vanceb/rLab_Door/README.md

# rLab_Door
A microcontroller project to allow members access to rLab
