vanceb/rLab_Door/Controller/kicad/README.md

# Production

## Kikit

Instructions for [kikit JLCPCB](https://github.com/yaqwsx/KiKit/blob/master/doc/fabrication/jlcpcb.md)

~~~sh
kikit fab jlcpcb --assembly --schematic rLab_Door.kicad_sch rLab_Door.kicad_pcb kikit_fab
~~~
