vanceb/rLab_Door/Pi_Connector/kicad/kikit_fab/bom.csv

Comment | Designator | Footprint | LCSC
PI | J1 | Connector_IDC:IDC-Header_2x04_P2.54mm_Vertical
Conn_02x20_Odd_Even | J2 | Connector_PinHeader_2.54mm:PinHeader_2x20_P2.54mm_Vertical
NFC SERIAL | J3 | TerminalBlock_Phoenix:TerminalBlock_Phoenix_MPT-0,5-4-2.54_1x04_P2.54mm_Horizontal
2N7002 | Q1,Q2 | Package_TO_SOT_SMD:SOT-23_Handsoldering | C8545
10k | R1,R2,R3,R4 | Resistor_SMD:R_0603_1608Metric_Pad0.98x0.95mm_HandSolder | C25804
SW_DPDT_x2 | SW1 | Button_Switch_THT:SW_CuK_JS202011CQN_DPDT_Straight
