vanceb/rLab_Door/Controller/kicad/3d/TS-1187A v2.iges

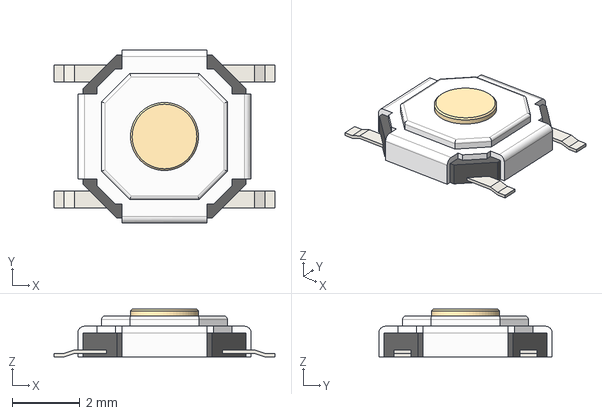
[picture p1: CAD file, 2022-09-25]
Controller/kicad/3d/TS-1187A v2.iges
6.50 x 5.10 x 1.40 mm
