vanceb/rLab_Door/Controller/kicad/rLab_Door.kicad_pcb

## KiCad design Controller/kicad/rLab_Door.kicad_pcb (2022-09-25)

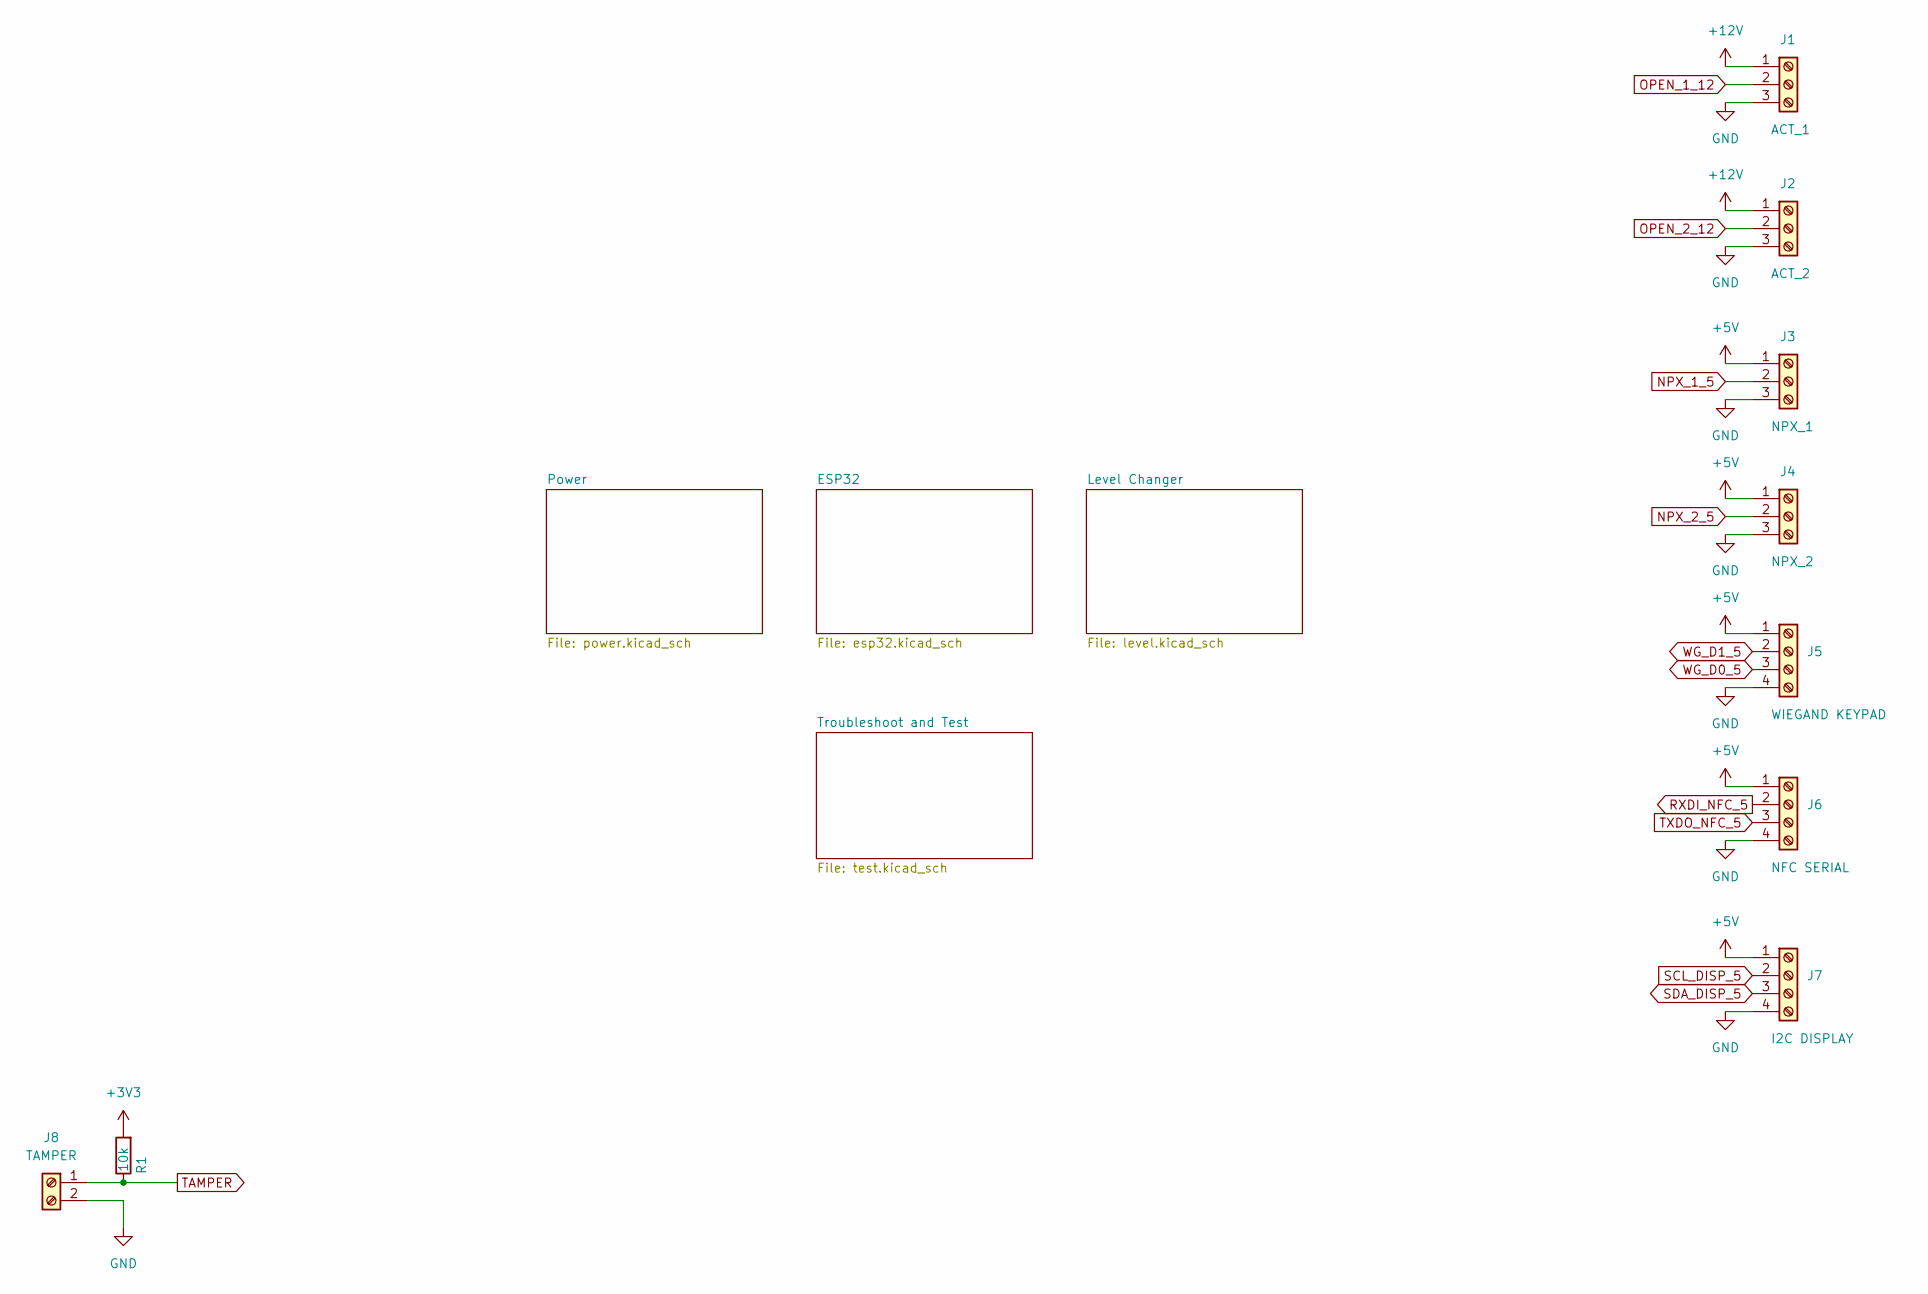
[picture p2: schematic rLab_Door.kicad_sch]

Parts:
J1: ACT_1; PinHeader_1x03_P2.54mm_Horizontal
J2: ACT_2; PinHeader_1x03_P2.54mm_Horizontal
J3: NPX_1; PinHeader_1x03_P2.54mm_Horizontal
J4: NPX_2; PinHeader_1x03_P2.54mm_Horizontal
J5: WIEGAND KEYPAD; PinHeader_1x04_P2.54mm_Horizontal
J6: NFC SERIAL; PinHeader_1x04_P2.54mm_Horizontal
J7: I2C DISPLAY; PinHeader_1x04_P2.54mm_Horizontal
J8: TAMPER; PinHeader_1x02_P2.54mm_Horizontal
R1: 10k; R_0603_1608Metric; LCSC C25804

Connections:
+3V3: R1.2; also elsewhere on the board
+5V: J3.1, J4.1, J5.1, J6.1, J7.1; also elsewhere on the board
+12V: J1.1, J2.1; also elsewhere on the board
GND: J1.3, J2.3, J3.3, J4.3, J5.4, J6.4, J7.4, J8.2; also elsewhere on the board
NPX_1_5: J3.2; also elsewhere on the board
NPX_2_5: J4.2; also elsewhere on the board
OPEN_1_12: J1.2; also elsewhere on the board
OPEN_2_12: J2.2; also elsewhere on the board
RXDI_NFC_5: J6.2; also elsewhere on the board
SCL_DISP_5: J7.2; also elsewhere on the board
SDA_DISP_5: J7.3; also elsewhere on the board
TAMPER: J8.1, R1.1; also elsewhere on the board
TXDO_NFC_5: J6.3; also elsewhere on the board
WG_D0_5: J5.3; also elsewhere on the board
WG_D1_5: J5.2; also elsewhere on the board

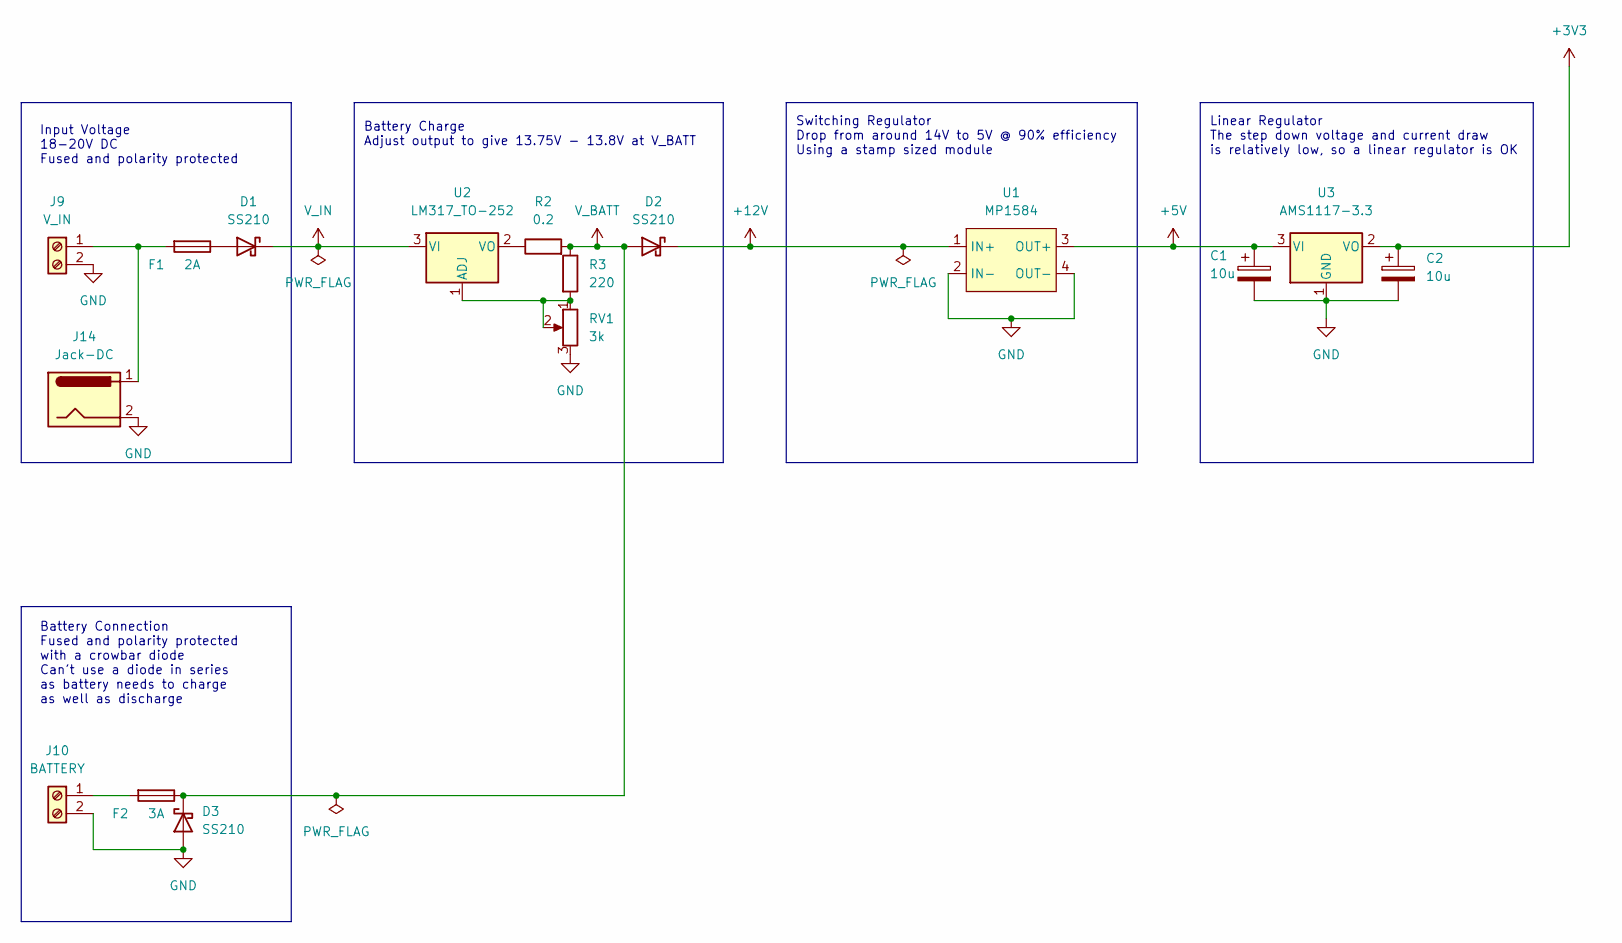
[picture p3: schematic power.kicad_sch]

Parts:
C1, C2: 10u; CP_EIA-3216-18_Kemet-A; LCSC C7171
D1, D2, D3: SS210; D_SMA; LCSC C14996
F1: 2A; Fuseholder_Cylinder-5x20mm_Schurter_0031_8201_Horizontal_Op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
F2: 3A; Fuseholder_Cylinder-5x20mm_Schurter_0031_8201_Horizontal_Op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
J9: V_IN; PinHeader_1x02_P2.54mm_Horizontal
J10: BATTERY; PinHeader_1x02_P2.54mm_Horizontal
J14: Jack-DC; BarrelJack_Horizontal
R2: 0.2; R_2512_6332Metric_Pad1.40x3.35mm_HandSolder; LCSC C841782
R3: 220; R_0603_1608Metric; LCSC C22962
RV1: 3k; Potentiometer_Bourns_3296W_Vertical
U1: MP1584
U2: LM317_TO-252; TO-252-2; LCSC C75510
U3: AMS1117-3.3; SOT-223-3_TabPin2; LCSC C6186

Connections:
+3V3: C2.1, U3.2 (VO); also elsewhere on the board
+5V: C1.1, U1.3 (OUT+), U3.3 (VI); also elsewhere on the board
+12V: D2.1 (K), U1.1 (IN+); also elsewhere on the board
GND: C1.2, C2.2, D3.2 (A), J9.2, J10.2, J14.2, RV1.3, U1.2 (IN-), U1.4 (OUT-), U3.1 (GND); also elsewhere on the board
unnamed: D1.2 (A), F1.1
unnamed: F1.2, J9.1, J14.1
unnamed: F2.2, J10.1
unnamed: R2.1, U2.2 (VO)
unnamed: R3.2, RV1.1, RV1.2, U2.1 (ADJ)
V_BATT: D2.2 (A), D3.1 (K), F2.1, R2.2, R3.1; also elsewhere on the board
V_IN: D1.1 (K), U2.3 (VI); also elsewhere on the board

Notes on the sheet:
Battery Charge Adjust output to give 13.75V - 13.8V at V_BATT
Linear Regulator The step down voltage and current draw is relatively low, so a linear regulator is OK
Battery Connection Fused and polarity protected with a crowbar diode Can't use a diode in series as battery needs to charge as well as discharge
Switching Regulator Drop from around 14V to 5V @ 90% efficiency Using a stamp sized module
Input Voltage 18-20V DC Fused and polarity protected

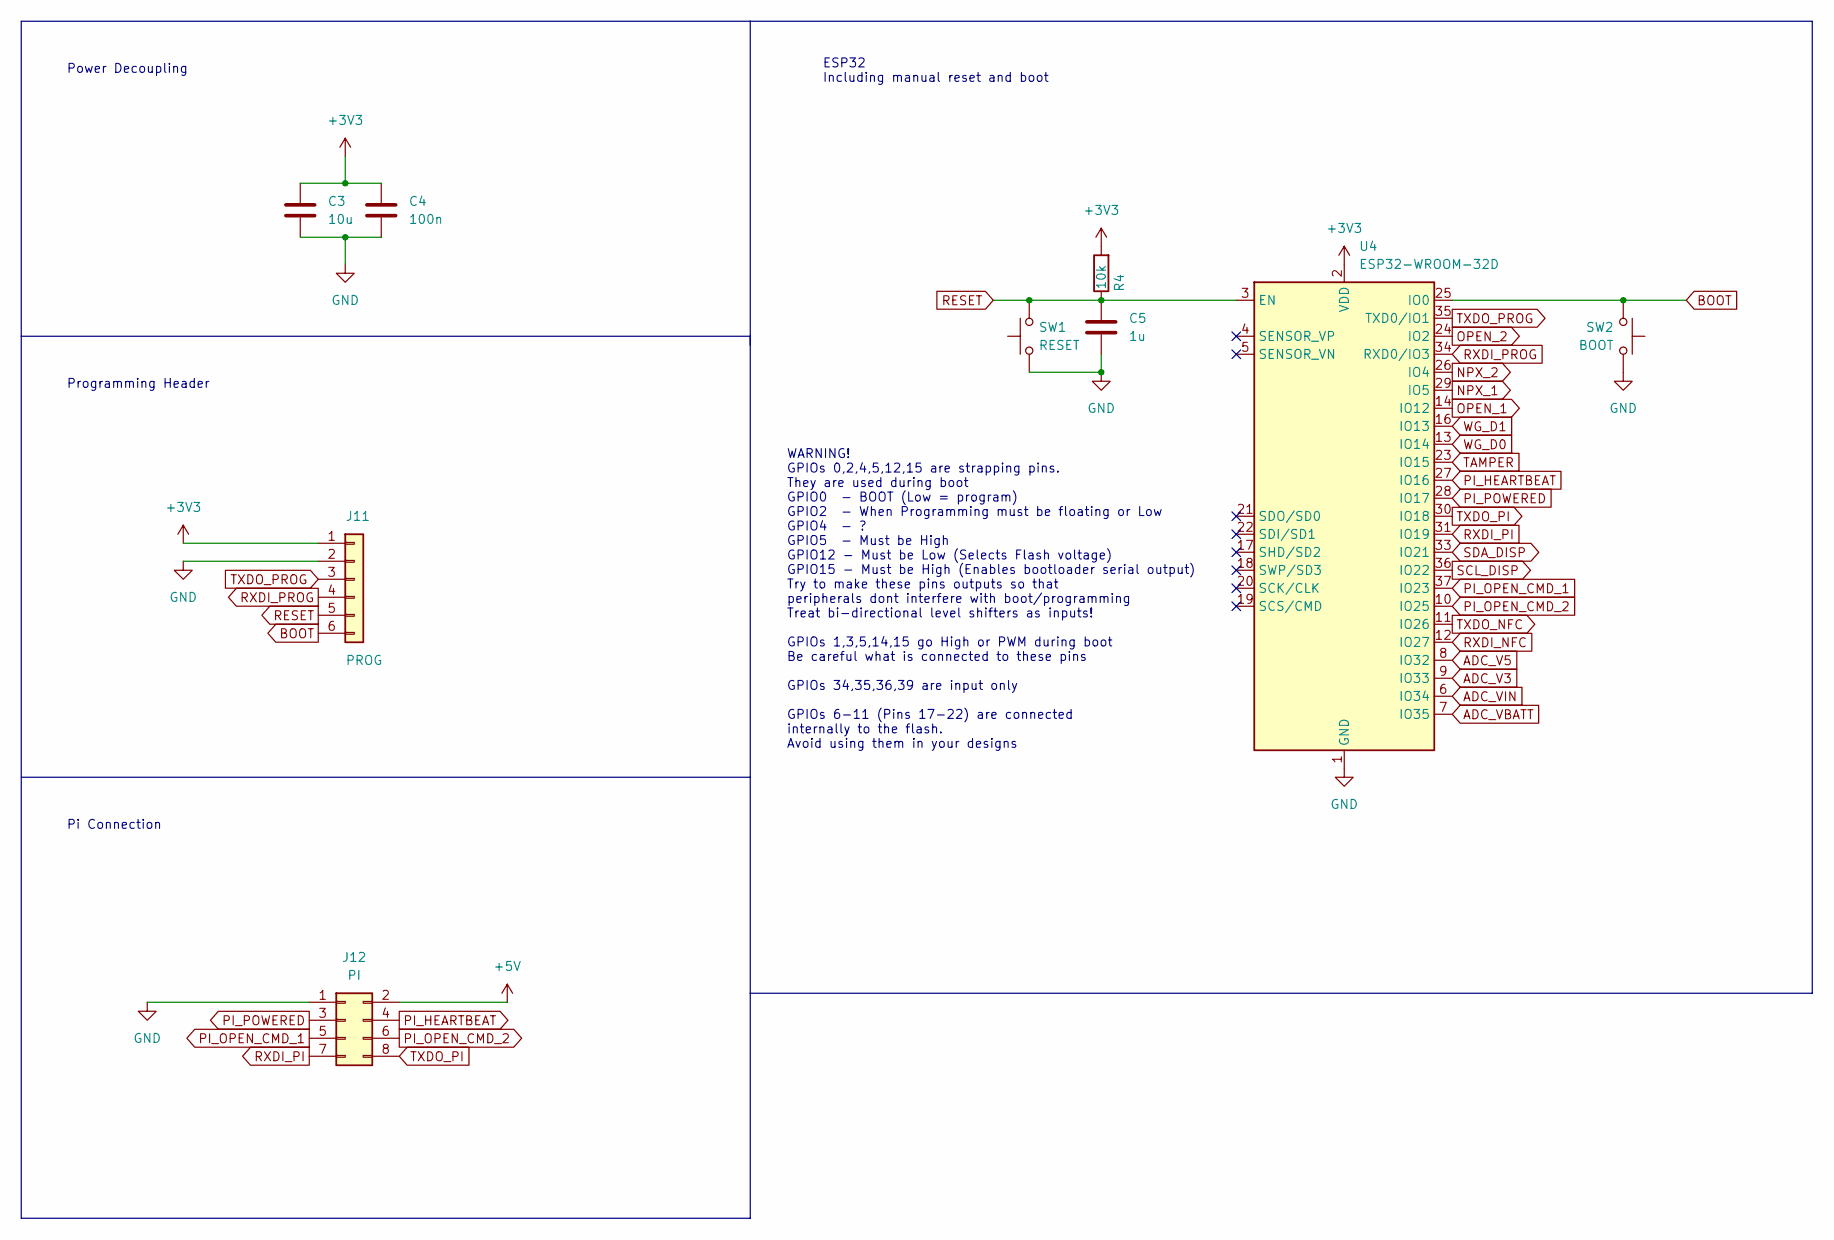
[picture p4: schematic esp32.kicad_sch]

Parts:
C3: 10u; C_1206_3216Metric; LCSC C13585
C4: 100n; C_0603_1608Metric; LCSC C14663
C5: 1u; C_0603_1608Metric; LCSC C15849
J11: PROG; PinHeader_1x06_P2.54mm_Vertical
J12: PI; IDC-Header_2x04_P2.54mm_Vertical
R4: 10k; R_0603_1608Metric; LCSC C25804
SW1: RESET; SW_Push_1P1T_NO_CK_KSC7xxJ; LCSC C318884
SW2: BOOT; SW_Push_1P1T_NO_CK_KSC7xxJ; LCSC C318884
U4: ESP32-WROOM-32D; ESP32-WROOM-32; LCSC C473012

Connections:
+3V3: C3.1, C4.1, J11.1, R4.2, U4.2 (VDD); also elsewhere on the board
+5V: J12.2; also elsewhere on the board
ADC_V3: U4.9 (IO33); also elsewhere on the board
ADC_V5: U4.8 (IO32); also elsewhere on the board
ADC_VBATT: U4.7 (IO35); also elsewhere on the board
ADC_VIN: U4.6 (IO34); also elsewhere on the board
BOOT: J11.6, SW2.2, U4.25 (IO0)
GND: C3.2, C4.2, C5.2, J11.2, J12.1, SW1.1, SW2.1, U4.1 (GND), U4.15 (GND), U4.38 (GND), U4.39 (GND); also elsewhere on the board
NPX_1: U4.29 (IO5); also elsewhere on the board
NPX_2: U4.26 (IO4); also elsewhere on the board
OPEN_1: U4.14 (IO12); also elsewhere on the board
OPEN_2: U4.24 (IO2); also elsewhere on the board
PI_HEARTBEAT: J12.4, U4.27 (IO16)
PI_OPEN_CMD_1: J12.5, U4.37 (IO23)
PI_OPEN_CMD_2: J12.6, U4.10 (IO25)
PI_POWERED: J12.3, U4.28 (IO17)
RESET: C5.1, J11.5, R4.1, SW1.2, U4.3 (EN)
RXDI_NFC: U4.12 (IO27); also elsewhere on the board
RXDI_PI: J12.7, U4.31 (IO19)
RXDI_PROG: J11.4, U4.34 (RXD0/IO3)
SCL_DISP: U4.36 (IO22); also elsewhere on the board
SDA_DISP: U4.33 (IO21); also elsewhere on the board
TAMPER: U4.23 (IO15); also elsewhere on the board
TXDO_NFC: U4.11 (IO26); also elsewhere on the board
TXDO_PI: J12.8, U4.30 (IO18)
TXDO_PROG: J11.3, U4.35 (TXD0/IO1)
WG_D0: U4.13 (IO14); also elsewhere on the board
WG_D1: U4.16 (IO13); also elsewhere on the board

Notes on the sheet:
Pi Connection
ESP32 Including manual reset and boot
Programming Header
WARNING! GPIOs 0,2,4,5,12,15 are strapping pins. They are used during boot GPIO0 - BOOT (Low = program) GPIO2 - When Programming must be floating or Low GPIO4 - ? GPIO5 - Must be High GPIO12 - Must be Low (Selects Flash voltage) GPIO15 - Must be High (Enables bootloader serial output) Try to make t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
Power Decoupling

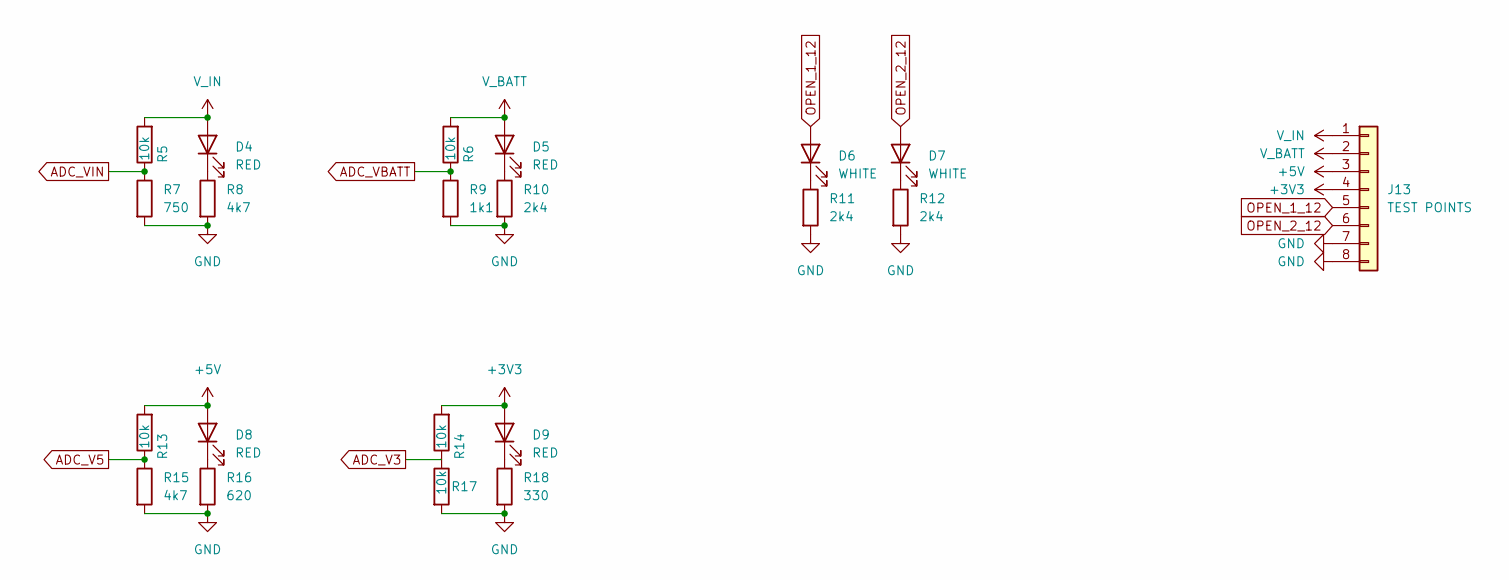
[picture p5: schematic test.kicad_sch]

Parts:
D4, D5, D8, D9: RED; LED_0603_1608Metric; LCSC C2286
D6, D7: WHITE; LED_0603_1608Metric; LCSC C2290
J13: TEST POINTS; PinHeader_1x08_P2.54mm_Vertical
R5, R6, R13, R14, R17: 10k; R_0603_1608Metric; LCSC C25804
R7: 750; R_0603_1608Metric; LCSC C23241
R8, R15: 4k7; R_0603_1608Metric; LCSC C23162
R9: 1k1; R_0603_1608Metric; LCSC C22764
R10, R11, R12: 2k4; R_0603_1608Metric; LCSC C22940
R16: 620; R_0603_1608Metric; LCSC C23220
R18: 330; R_0603_1608Metric; LCSC C23138

Connections:
+3V3: D9.2 (A), J13.4, R14.2; also elsewhere on the board
+5V: D8.2 (A), J13.3, R13.2; also elsewhere on the board
ADC_V3: R14.1, R17.1; also elsewhere on the board
ADC_V5: R13.1, R15.1; also elsewhere on the board
ADC_VBATT: R6.1, R9.1; also elsewhere on the board
ADC_VIN: R5.1, R7.1; also elsewhere on the board
GND: J13.7, J13.8, R7.2, R8.2, R9.2, R10.2, R11.2, R12.2, R15.2, R16.2, R17.2, R18.2; also elsewhere on the board
unnamed: D4.1 (K), R8.1
unnamed: D5.1 (K), R10.1
unnamed: D6.1 (K), R11.1
unnamed: D7.1 (K), R12.1
unnamed: D8.1 (K), R16.1
unnamed: D9.1 (K), R18.1
OPEN_1_12: D6.2 (A), J13.5; also elsewhere on the board
OPEN_2_12: D7.2 (A), J13.6; also elsewhere on the board
V_BATT: D5.2 (A), J13.2, R6.2; also elsewhere on the board
V_IN: D4.2 (A), J13.1, R5.2; also elsewhere on the board

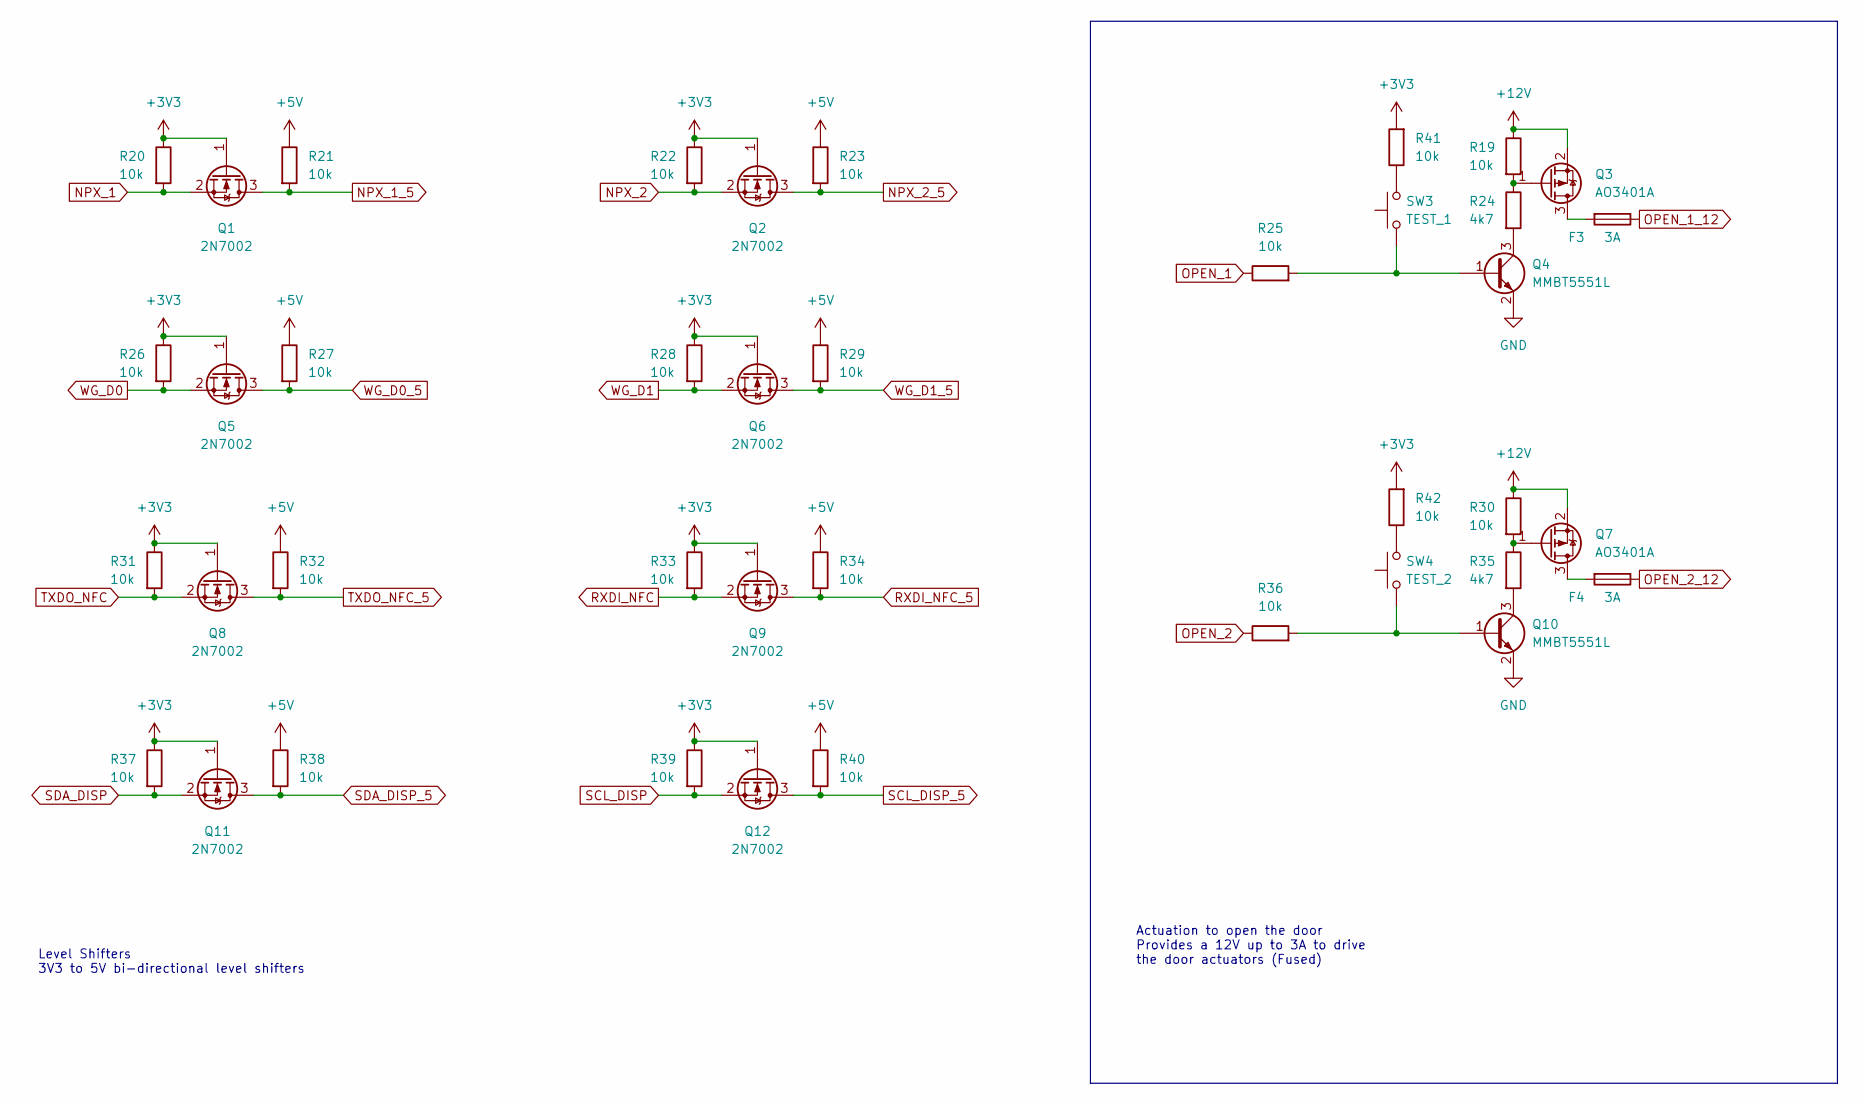
[picture p6: schematic level.kicad_sch]

Parts:
F3, F4: 3A; Fuseholder_Cylinder-5x20mm_Schurter_0031_8201_Horizontal_Op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
Q1, Q2, Q5, Q6, Q8, Q9, Q11, Q12: 2N7002; SOT-23; LCSC C8545
Q3, Q7: AO3401A; SOT-23; LCSC C15127
Q4, Q10: MMBT5551L; SOT-23; LCSC C2145
R19, R20, R21, R22, R23, R25, R26, R27, R28, R29, R30, R31, R32, R33, R34, R36, R37, R38, R39, R40, R41, R42: 10k; R_0603_1608Metric; LCSC C25804
R24, R35: 4k7; R_0603_1608Metric; LCSC C23162
SW3: TEST_1; SW_Push_1P1T_NO_CK_KSC7xxJ; LCSC C318884
SW4: TEST_2; SW_Push_1P1T_NO_CK_KSC7xxJ; LCSC C318884

Connections:
+3V3: Q1.1 (G), Q2.1 (G), Q5.1 (G), Q6.1 (G), Q8.1 (G), Q9.1 (G), Q11.1 (G), Q12.1 (G), R20.1, R22.1, R26.1, R28.1, R31.1, R33.1, R37.1, R39.1, R41.2, R42.2; also elsewhere on the board
+5V: R21.1, R23.1, R27.1, R29.1, R32.1, R34.1, R38.1, R40.1; also elsewhere on the board
+12V: Q3.2 (S), Q7.2 (S), R19.1, R30.1; also elsewhere on the board
GND: Q4.2 (E), Q10.2 (E); also elsewhere on the board
NPX_1: Q1.2 (S), R20.2; also elsewhere on the board
NPX_1_5: Q1.3 (D), R21.2; also elsewhere on the board
NPX_2: Q2.2 (S), R22.2; also elsewhere on the board
NPX_2_5: Q2.3 (D), R23.2; also elsewhere on the board
unnamed: F3.2, Q3.3 (D)
unnamed: F4.2, Q7.3 (D)
unnamed: Q3.1 (G), R19.2, R24.1
unnamed: Q4.1 (B), R25.2, SW3.1
unnamed: Q4.3 (C), R24.2
unnamed: Q7.1 (G), R30.2, R35.1
unnamed: Q10.1 (B), R36.2, SW4.1
unnamed: Q10.3 (C), R35.2
unnamed: R41.1, SW3.2
unnamed: R42.1, SW4.2
OPEN_1: R25.1; also elsewhere on the board
OPEN_1_12: F3.1; also elsewhere on the board
OPEN_2: R36.1; also elsewhere on the board
OPEN_2_12: F4.1; also elsewhere on the board
RXDI_NFC: Q9.2 (S), R33.2; also elsewhere on the board
RXDI_NFC_5: Q9.3 (D), R34.2; also elsewhere on the board
SCL_DISP: Q12.2 (S), R39.2; also elsewhere on the board
SCL_DISP_5: Q12.3 (D), R40.2; also elsewhere on the board
SDA_DISP: Q11.2 (S), R37.2; also elsewhere on the board
SDA_DISP_5: Q11.3 (D), R38.2; also elsewhere on the board
TXDO_NFC: Q8.2 (S), R31.2; also elsewhere on the board
TXDO_NFC_5: Q8.3 (D), R32.2; also elsewhere on the board
WG_D0: Q5.2 (S), R26.2; also elsewhere on the board
WG_D0_5: Q5.3 (D), R27.2; also elsewhere on the board
WG_D1: Q6.2 (S), R28.2; also elsewhere on the board
WG_D1_5: Q6.3 (D), R29.2; also elsewhere on the board

Notes on the sheet:
Level Shifters 3V3 to 5V bi-directional level shifters
Actuation to open the door Provides a 12V up to 3A to drive the door actuators (Fused)

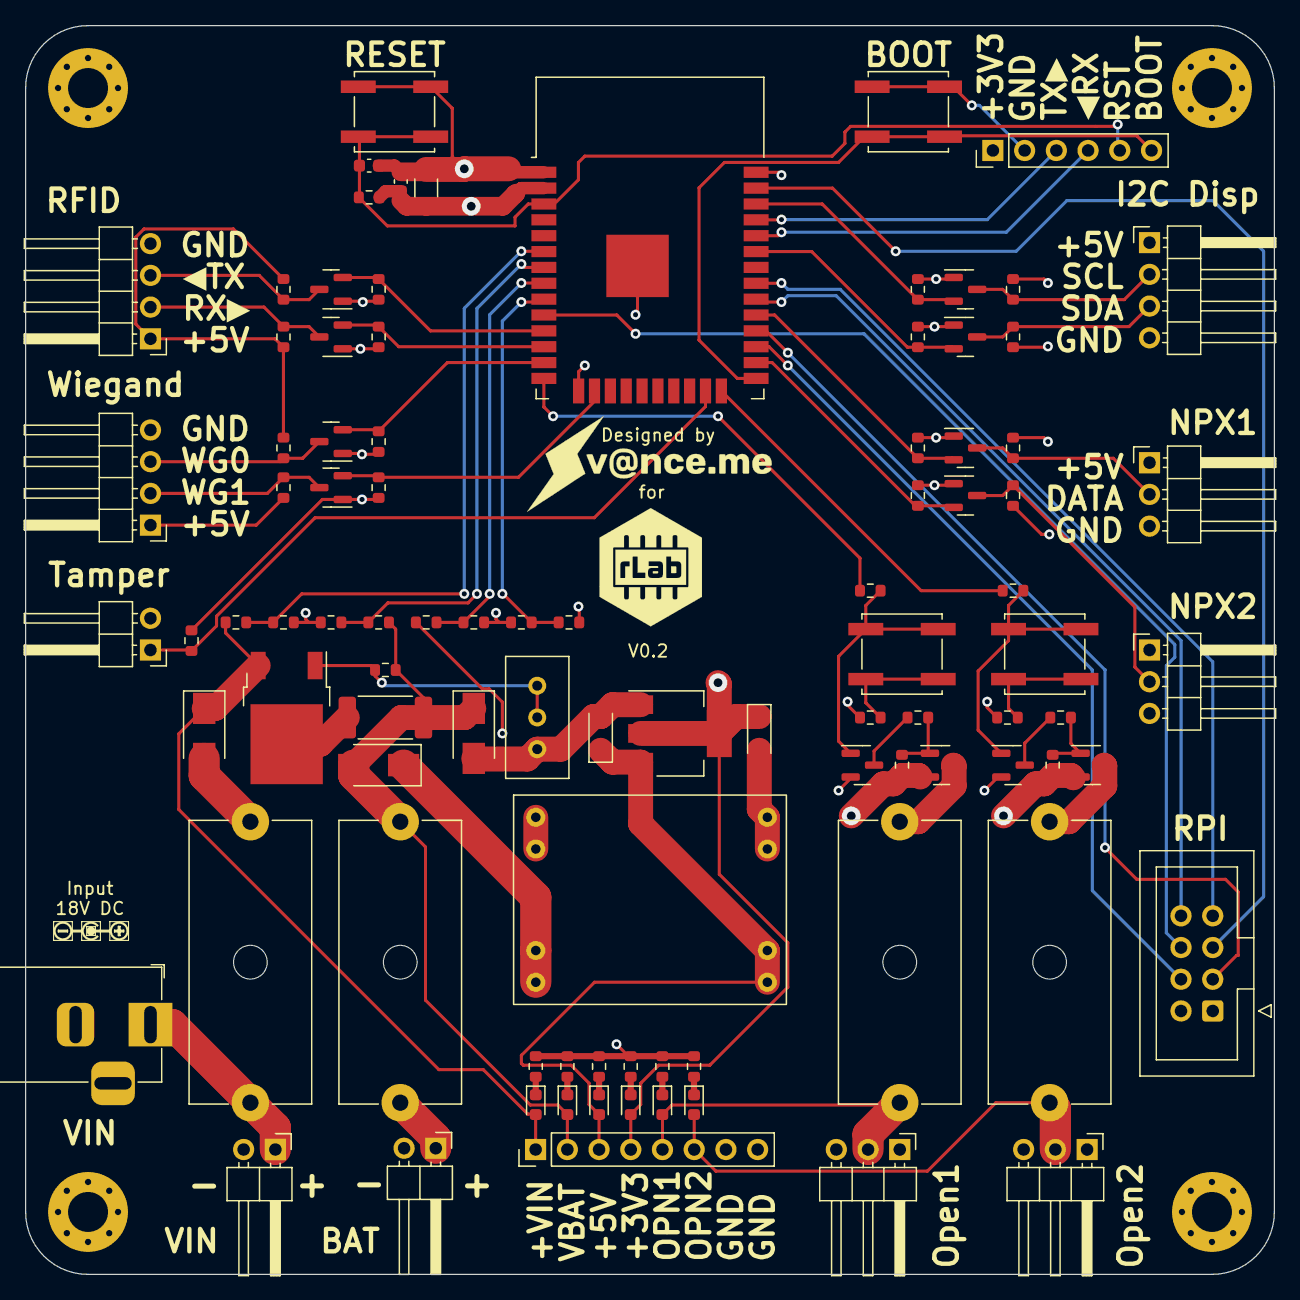
[picture p7: board rLab_Door.kicad_pcb from above]

Board: 4 copper layers, 100.0 x 100.0 mm, 95 parts (0 on the bottom side), 62 nets.
