vanceb/rLab_Door/Pi_Connector/kicad/Pi_Connector.kicad_pcb

## KiCad design Pi_Connector/kicad/Pi_Connector.kicad_pcb (2022-07-01)

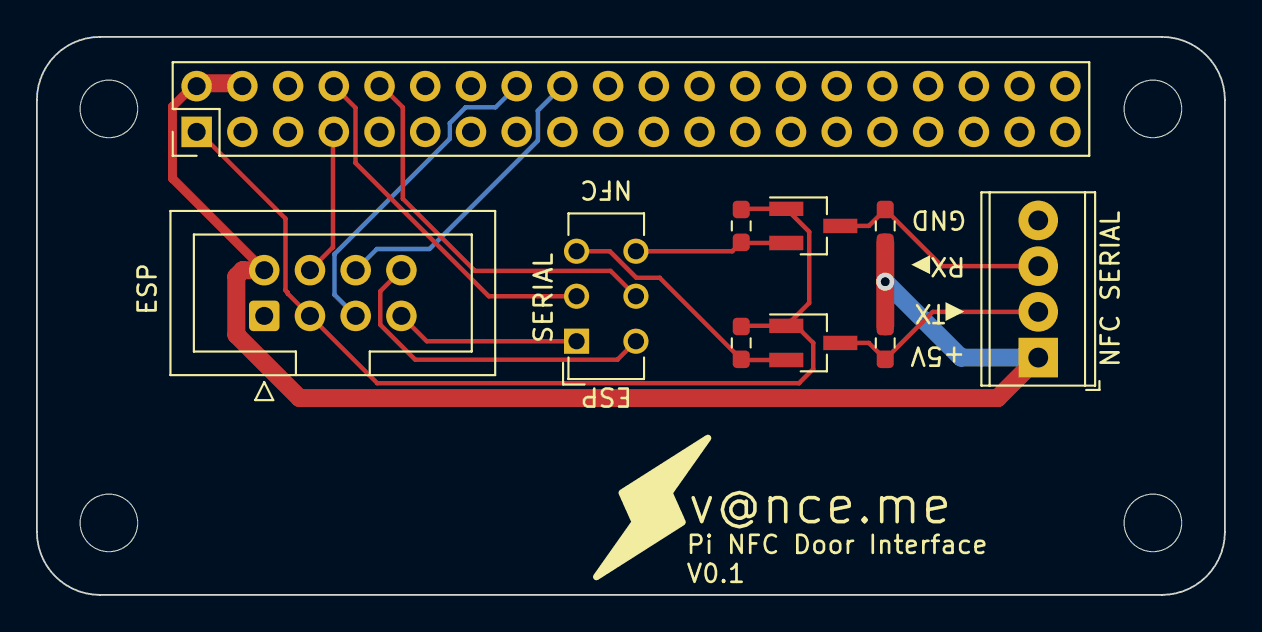
[picture p8: board Pi_Connector.kicad_pcb from above]

Board: 2 copper layers, 66.0 x 31.0 mm, 10 parts (0 on the bottom side), 14 nets.

Parts:
J1: PI; IDC-Header_2x04_P2.54mm_Vertical
J2: Conn_02x20_Odd_Even; PinHeader_2x20_P2.54mm_Vertical
J3: NFC SERIAL; TerminalBlock_Phoenix_MPT-0,5-4-2.54_1x04_P2.54mm_Horizontal
Q1, Q2: 2N7002; SOT-23_Handsoldering
R1, R2, R3, R4: 10k; R_0603_1608Metric_Pad0.98x0.95mm_HandSolder
SW1: SW_DPDT_x2; SW_CuK_JS202011CQN_DPDT_Straight

Connections:
+5V: J1.2, J2.2, J2.4, J3.1, R2.1, R4.1
GND: J1.1, J2.6, J2.9, J2.14, J2.20, J2.25, J2.30, J2.34, J2.39, J3.4
PI_HEARTBEAT: J1.4, J2.7
PI_OPEN_CMD_1: J1.5, J2.16
PI_OPEN_CMD_2: J1.6, J2.18
PI_POWERED: J1.3, J2.1, Q1.1 (G), Q2.1 (G), R1.1, R3.1
RXDI: J2.10, SW1.5 (B)
RXDI_ESP: J1.8, SW1.4 (A)
RXDI_NFC: Q2.2 (S), R3.2, SW1.6 (C)
RXDI_NFC_5: J3.3, Q2.3 (D), R4.2
TXDO: J2.8, SW1.2 (B)
TXDO_ESP: J1.7, SW1.1 (A)
TXDO_NFC: Q1.2 (S), R1.2, SW1.3 (C)
TXDO_NFC_5: J3.2, Q1.3 (D), R2.2
