vanceb/rLab_Door/(commit log)

2022-06-27 Added .gitignore for kicad from github
2022-06-27 Board files ready for the generation of fabrication outputs
    [door.kicad_sch, esp32.kicad_sch, level.kicad_sch, pi_connection.kicad_sch, power.kicad_sch, rLab_Door.kicad_pcb, rLab_Door.kicad_sch, test.kicad_sch]
2022-06-27 V0.1 fabrication files
    [rLab_Door-CmtUser.gbr, rLab_Door-CuBottom.gbl, rLab_Door-CuTop.gtl, rLab_Door-EdgeCuts.gm1, rLab_Door-MaskBottom.gbs, rLab_Door-MaskTop.gts, rLab_Door-PasteBottom.gbp, rLab_Door-PasteTop.gtp]
2022-06-30 Rework of power circuits to improve protection
    [esp32.kicad_sch, level.kicad_sch, pi_connection.kicad_sch, power.kicad_sch, rLab_Door.kicad_pcb, rLab_Door.kicad_sch, test.kicad_sch]
2022-06-30 Final check of ERC and DRC before fabrication outputs
    [rLab_Door.kicad_pcb]
2022-06-30 Improved V_IN and BATTERY traces to handle up to 4A current
    [rLab_Door.kicad_pcb]
2022-06-30 Generated gerbers for fabrication
    [rLab_Door-CmtUser.gbr, rLab_Door-CuBottom.gbl, rLab_Door-CuTop.gtl, rLab_Door-EdgeCuts.gm1, rLab_Door-MaskBottom.gbs, rLab_Door-MaskTop.gts, rLab_Door-PasteBottom.gbp, rLab_Door-PasteTop.gtp]
2022-07-01 Initial design
    [Pi_Connector.kicad_pcb, Pi_Connector.kicad_sch]
2022-07-01 Created gerbers for fabrication
    [Pi_Connector-CmtUser.gbr, Pi_Connector-CuBottom.gbl, Pi_Connector-CuTop.gtl, Pi_Connector-EdgeCuts.gm1, Pi_Connector-MaskBottom.gbs, Pi_Connector-MaskTop.gts, Pi_Connector-PasteBottom.gbp, Pi_Connector-PasteTop.gtp]
2022-07-01 Rounded corners of the board, added M3 mounting holes and recentered components
    [rLab_Door.kicad_pcb]
2022-07-01 Minor tweak to silkscreen abd generation of gerbers for fabrication
    [rLab_Door-CmtUser.gbr, rLab_Door-CuBottom.gbl, rLab_Door-CuTop.gtl, rLab_Door-EdgeCuts.gm1, rLab_Door-MaskBottom.gbs, rLab_Door-MaskTop.gts, rLab_Door-PasteBottom.gbp, rLab_Door-PasteTop.gtp]
2022-07-01 Tweaked .gitignore to track bom.csv and pos.csv files needed for fabrication
    [bom.csv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]
2022-07-01 Added some vias to the high power connections to improve current capacity
    [rLab_Door.kicad_pcb]
2022-07-01 regenerated gerbers after changes to board
    [rLab_Door-CmtUser.gbr, rLab_Door-CuBottom.gbl, rLab_Door-CuTop.gtl, rLab_Door-EdgeCuts.gm1, rLab_Door-MaskBottom.gbs, rLab_Door-MaskTop.gts, rLab_Door-PasteBottom.gbp, rLab_Door-PasteTop.gtp]
2022-07-01 Moved main board files into Controller/kicad
    [bom.csv, door.kicad_sch, esp32.kicad_sch, level.kicad_sch, power.kicad_sch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]
2022-07-02 Tweaked board to allow for JLCPCB standard assembly. Needed fiducials and 5mm rail clearance top and bottom. Also fixed silkscreen mistake
    [esp32.kicad_sch, level.kicad_sch, power.kicad_sch, rLab_Door.kicad_pcb, test.kicad_sch]
2022-07-03 Generated fabrication files
    [pos.csv, rLab_Door-CmtUser.gbr, rLab_Door-CuBottom.gbl, rLab_Door-CuTop.gtl, rLab_Door-EdgeCuts.gm1, rLab_Door-MaskBottom.gbs, rLab_Door-MaskTop.gts, rLab_Door-PasteBottom.gbp]
2022-07-14 Updated schematics based on issues and improvements from the prototype board
    [esp32.kicad_sch, level.kicad_sch, power.kicad_sch, rLab_Door.kicad_sch]
2022-07-25 Added system voltage monitoring
2022-07-25 Battery charge tested, useful messages to character display. Disabled neopix and they seemed to hang the system
2022-07-26 Switched to Adafruit neopixel library
2022-07-29 Added log warnings into the voltage check code
2022-08-25 Updated schematic to fix issues with V1, including incorrect PCB layout for MP1584
    [esp32.kicad_sch]
2022-09-08 Pre-production check-in
    [esp32.kicad_sch, level.kicad_sch, power.kicad_sch, rLab_Door.kicad_pcb, rLab_Door.kicad_sch, test.kicad_sch]
2022-09-08 PCB save
    [rLab_Door.kicad_pcb]
2022-09-08 Production of V0.2
    [bom.csv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]
2022-09-25 First working version on V0.2 hardware
    [TS-1187A v2.iges, rLab_Door.kicad_pcb]
2022-11-02 Monor tweaks and the creation of STEP 3D Models for use in imechanical CAD
    [test.kicad_sch]
